Yuto2511/RoboTrace_2023/README.md

# RoboTrace_2023

2023年に製作するロボトレーサーのリポジトリ(見返すためのメモ)  

## Technical data

### CPU 
ARM系 / STmicro stm32f405

### バッテリー
CPU,モータ共用  
Lipo / 3セル / -[v] / -[mAh] / -  

### モータ
- 走行用　DCモータ : 2[個] / maxon DCX10L  
- 走行以外 DCモータ : 1[個] / maxon DCX8M  
- モータドライバIC : DRV8874,DRV8876

### センサ
- 赤外線センサ : 6[個] / TEMT7100X01 / ラインセンサ(反射光AD変換)  
- 赤外線センサ : 2[個] / S7136 / サイドセンサ  
- ジャイロセンサ : 1[個] / ICM20649 / デジタル値出力型  
- エンコーダ : 2[個] / ENX 10 EASY  
- エンコーダ : 1[個] / ENX 8 MAG  

### サイズ
- -x-[mm]
- -[g]

### 動輪
4輪 / 直径24mm 幅　12mm

### 速度
- 直進最高速度 : -[m/s]
- 加速度 : -[m/s^2]
- 加速度 : -[m/s^2]

## 機械設計
### CAD
RoboTrace_2023_aseembly

### モータ
- 駆動輪 : DCX10L
- センサステア : DCX8M
- 吸引 : 8520モータ

### ギヤ
- 駆動輪
  - ピニオン : M0.3, Z28
  - 動輪ギヤ : M0.3, Z63
- センサステア
  - ピニオン : M0.5, Z10
  - [クラウンギヤ](https://www.tamiya.com/japan/products/15462/index.html) : M0.5, Z20
  - [スパーギヤ](https://www.tamiya.com/japan/products/15434/index.html) : M0.5, Z26

### その他
- フレーム : カーボン板(1mm)
- プリントパーツ : Onyx(Mark Two), -(光造形)
- シャフト : アルミ丸棒(4mm), ステンレス丸棒(3mm)
- ベアリング : 内径4mm外形7mm, 内径3mm外形6mm
- ねじ : M2, M2.6

## 回路設計

### 回路図
[回路図](https://github.com/Yuto2511/RoboTrace_2023/blob/main/RoboTrace_2023.pdf)

### パーツ一覧

#### CPU
- [STM32F405RGT6](https://www.stmcu.jp/stm32/stm32f4/stm32f405415/12229/) o
- [クロック-DSC6021CI2](https://www.digikey.jp/ja/products/detail/microchip-technology/DSC6021CI2A-009S/8639204) o

#### 電源
- XT60コネクタ-オス-XT60U-M o
- IL-Gコネクタ-2極-2.5ピッチ-IL-G-2P-S3T2-SA o
- [PchMOSFET-55V-18A](https://akizukidenshi.com/catalog/g/gI-06021/) x
- [DC/DC-LXDC55FAAA-203](https://akizukidenshi.com/catalog/g/gM-09577/) o
- [積層セラミックコンデンサ-4.7uF-50V](https://akizukidenshi.com/catalog/g/gP-15634/) o
- [アルミ電解コンデンサ-100uF-16V](https://akizukidenshi.com/catalog/g/gP-17422/) o
- [積層セラミックコンデンサ-2.2uF-35V](https://akizukidenshi.com/catalog/g/gP-16077/) o
- [積層セラミックコンデンサ-10uF-35V](https://akizukidenshi.com/catalog/g/gP-13336/) x
- [レギュレタ-NJU7223DL1](https://akizukidenshi.com/catalog/g/gI-03705/) x
- [ショットキーバリアダイオード-MA10EB045](https://www.digikey.jp/ja/products/detail/kyocera-avx/MA10EB045/16580541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) o
- [スライドスイッチ-1回路2接点](https://akizukidenshi.com/catalog/g/gP-13989/) x
- [緑色チップLED-OSTG1608C1A](https://akizukidenshi.com/catalog/g/gI-06417/) o

#### モータ
- [モータドライバ-DRV8874](https://www.mouser.jp/ProductDetail/Texas-Instruments/DRV8874QPWPRQ1?qs=mAH9sUMRCttZUT1myh3Itg%3D%3D) o
- [モータドライバ-DRV8876](https://www.digikey.jp/ja/products/detail/texas-instruments/DRV8876PWPR/10270191) o
- [積層セラミックコンデンサ-22pF-50V](https://akizukidenshi.com/catalog/g/gP-11626/) o
- [アルミ電解コンデンサ-100uF-16V](https://akizukidenshi.com/catalog/g/gP-17422/) o
- PAコネクタ-2極 o
- [FFCコネクタ-12極-0.5ピッチ](https://www.digikey.jp/ja/products/detail/molex/0527451297/3044841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) o
- FTSHコネクタ-10極-1.27ピッチ-FTSH-105-01-L-D-K o
- [NchMOSFET-30V-5.7A](https://akizukidenshi.com/catalog/g/gI-14653/) x
- [ショットキーバリアダイオード-40V-2A](https://akizukidenshi.com/catalog/g/gI-02073/) x
- [積層セラミックコンデンサ-10uF-35V](https://akizukidenshi.com/catalog/g/gP-13336/) x

#### センサ
- [IMU-ICM20649](https://www.digikey.jp/ja/products/detail/tdk-invensense/ICM-20649/8540792) o
- [フォトトランジスタ-TEMT7100X01](https://www.digikey.jp/ja/products/detail/vishay-semiconductor-opto-division/TEMT7100X01/4743803) o
- [赤外線LED-SIR19-21/TR8](https://www.digikey.jp/ja/products/detail/everlight-electronics-co-ltd/SIR19-21C-TR8/2676159) o
- [光変調型フォトIC-S7136](https://akizukidenshi.com/catalog/g/gI-02425/) o
- [FFCケーブル-8極-0.5ピッチ](https://www.digikey.jp/ja/products/detail/molex/0151660081/3280963) x  
- [FFCコネクタ-8極-0.5ピッチ](https://www.digikey.jp/ja/products/detail/molex/5051100892/5700456) x  

#### その他・共通
- [白色チップLED-OSWT1608](https://akizukidenshi.com/catalog/g/gI-03986/) o
- [表面実装タクトスイッチ-TVAF06-A020B-R](https://akizukidenshi.com/catalog/g/gP-14888/) o
- SHコネクタ-3~6極-1.0ピッチ o

## プログラム
