Yuto2511/RoboTrace_2023/Core/Src/main.c

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
/* Includes ------------------------------------------------------------------*/
#include "main.h"

/* USER CODE BEGIN Includes */
#include "wrapper.h"
#include <stdio.h>
/* USER CODE END Includes */

ADC_HandleTypeDef hadc1;
DMA_HandleTypeDef hdma_adc1;

I2C_HandleTypeDef hi2c1;

RTC_HandleTypeDef hrtc;

SPI_HandleTypeDef hspi1;

TIM_HandleTypeDef htim1;
TIM_HandleTypeDef htim2;
TIM_HandleTypeDef htim3;
TIM_HandleTypeDef htim4;
TIM_HandleTypeDef htim5;
TIM_HandleTypeDef htim6;
TIM_HandleTypeDef htim7;
TIM_HandleTypeDef htim8;
TIM_HandleTypeDef htim9;
TIM_HandleTypeDef htim10;
TIM_HandleTypeDef htim11;
TIM_HandleTypeDef htim12;

UART_HandleTypeDef huart1;

void SystemClock_Config(void);
static void MX_GPIO_Init(void);
static void MX_DMA_Init(void);
static void MX_ADC1_Init(void);
static void MX_I2C1_Init(void);
static void MX_RTC_Init(void);
static void MX_SPI1_Init(void);
static void MX_TIM1_Init(void);
static void MX_TIM2_Init(void);
static void MX_TIM3_Init(void);
static void MX_TIM4_Init(void);
static void MX_TIM5_Init(void);
static void MX_TIM8_Init(void);
static void MX_TIM9_Init(void);
static void MX_TIM10_Init(void);
static void MX_TIM11_Init(void);
static void MX_TIM12_Init(void);
static void MX_USART1_UART_Init(void);
static void MX_TIM6_Init(void);
static void MX_TIM7_Init(void);
/* USER CODE BEGIN PFP */
int _write(int, char*, int);
/* USER CODE END PFP */

/* USER CODE BEGIN 0 */

const uint32_t start_address_sector10 = 0x80C0000;	//sector10 start address
const uint32_t end_address_sector10 = 0x80DFFFF;		//sector10 end address
const uint32_t start_address_sector11 = 0x80E0000;	//sector11 start address
const uint32_t end_address_sector11 = 0x80FFFFF;		//sector11 end address

WRITE_DATA_SECTOR11 write_data_sector11 = {{0}};
READ_DATA_SECTOR11 read_data_sector11 = {{0}};
WRITE_DATA_SECTOR10 write_data_sector10 = {{0}};
READ_DATA_SECTOR10 read_data_sector10 = {{0}};

int _write(int file, char *ptr, int len) {
	HAL_UART_Transmit(&huart1, (uint8_t*)ptr, len, 0xFFFF);
	return len;
}

/* USER CODE END 0 */

/**
  * @brief  The application entry point.
  * @retval int
  */
int main(void)
{
  /* MCU Configuration--------------------------------------------------------*/

  /* Reset of all peripherals, Initializes the Flash interface and the Systick. */
  HAL_Init();

  /* Configure the system clock */
  SystemClock_Config();

  /* Initialize all configured peripherals */
  MX_GPIO_Init();
  MX_DMA_Init();
  MX_ADC1_Init();
  MX_I2C1_Init();
  MX_RTC_Init();
  MX_SPI1_Init();
  MX_TIM1_Init();
  MX_TIM2_Init();
  MX_TIM3_Init();
  MX_TIM4_Init();
  MX_TIM5_Init();
  MX_TIM8_Init();
  MX_TIM9_Init();
  MX_TIM10_Init();
  MX_TIM11_Init();
  MX_TIM12_Init();
  MX_USART1_UART_Init();
  MX_TIM6_Init();
  MX_TIM7_Init();
  /* USER CODE BEGIN 2 */
  HAL_TIM_Base_Start_IT(&htim6);
  HAL_TIM_Base_Start_IT(&htim7);
  init();
  // reload flash data
  loadFlash(start_address_sector11, (uint8_t*)&read_data_sector11, sizeof(READ_DATA_SECTOR11));
  loadFlash(start_address_sector10, (uint8_t*)&read_data_sector10, sizeof(READ_DATA_SECTOR10));

  /* USER CODE END 2 */

  /* Infinite loop */
  /* USER CODE BEGIN WHILE */
  while (1)
  {
	  main_loop();
    /* USER CODE END WHILE */

    /* USER CODE BEGIN 3 */
  }
  /* USER CODE END 3 */
}

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
/* USER CODE BEGIN 4 */
void HAL_TIM_PeriodElapsedCallback(TIM_HandleTypeDef *htim)
{
	// TIM6
	if (htim->Instance == TIM6)
	{
		PeriodElapsed_005ms();
	}
	// TIM7
	if (htim->Instance == TIM7)
	{
		PeriodElapsed_05ms();
	}
}
/* USER CODE END 4 */
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
