Yuto2511/RoboTrace_2023/Core/Inc/accelerometer.h

/*
 * accelerometer.h
 *
 *  Created on: Jan 17, 2024
 *      Author: youto
 */

#ifndef INC_ACCELEROMETER_H_
#define INC_ACCELEROMETER_H_

#include "ICM_20649.h"

double pre_zg;

double z_gyro();

#endif /* INC_ACCELEROMETER_H_ */
