Yuto2511/RoboTrace_2023/Core/Inc/analog.h

/*
 * analog.h
 *
 *  Created on: Jan 17, 2024
 *      Author: youto
 */

#ifndef INC_ANALOG_H_
#define INC_ANALOG_H_

#include <stdio.h>
#include "stm32f4xx_hal.h"
#include "macro.h"

extern ADC_HandleTypeDef hadc1;
extern DMA_HandleTypeDef hdma_adc1;

void ADCStart();
void adc_getValues();
void updateValues();
void Sens_Calibration();

uint32_t num;
uint16_t line_R1_[10], line_R2_[10], line_R3_[10], line_L1_[10], line_L2_[10], line_L3_[10];
uint16_t analog_[ADC_SENS];
int R_Min, R_Max, L_Min, L_Max;
float Line_Sens_R, Line_Sens_L, Stear_Sens, Line_Calib_R, Line_Calib_L;

#endif /* INC_ANALOG_H_ */
