Yuto2511/RoboTrace_2023/Core/Inc/led.h

/*
 * led.h
 *
 *  Created on: Jan 17, 2024
 *      Author: youto
 */

#ifndef INC_LED_H_
#define INC_LED_H_

#include "stm32f4xx_hal.h"

void led_num(uint8_t num);
void led_flg(uint8_t flg);

#endif /* INC_LED_H_ */
