Yuto2511/RoboTrace_2023/Core/Src/led.c

/*
 * led.c
 *
 *  Created on: Jan 17, 2024
 *      Author: youto
 */


#include "led.h"

void led_num(uint8_t num)
{
	// 1000
	if(num >= 8){
		num = num - 8;
		HAL_GPIO_WritePin(GPIOD, GPIO_PIN_2, GPIO_PIN_RESET);
	}
	else HAL_GPIO_WritePin(GPIOD, GPIO_PIN_2, GPIO_PIN_SET);
	// 0001
	if( !(num % 2) ) HAL_GPIO_WritePin(GPIOC, GPIO_PIN_0, GPIO_PIN_RESET);
	else HAL_GPIO_WritePin(GPIOC, GPIO_PIN_0, GPIO_PIN_SET);

	// 0010
	if( (num/2)%2 ) HAL_GPIO_WritePin(GPIOC, GPIO_PIN_14, GPIO_PIN_RESET);
	else HAL_GPIO_WritePin(GPIOC, GPIO_PIN_14, GPIO_PIN_SET);

	// 0100
	if( num >= 4 ) HAL_GPIO_WritePin(GPIOC, GPIO_PIN_12, GPIO_PIN_RESET);
	else HAL_GPIO_WritePin(GPIOC, GPIO_PIN_12, GPIO_PIN_SET);
}

void led_flg(uint8_t flg)
{
	if(flg) HAL_GPIO_WritePin(GPIOD, GPIO_PIN_2, GPIO_PIN_RESET);
	else HAL_GPIO_WritePin(GPIOD, GPIO_PIN_2, GPIO_PIN_SET);
}
