Yuto2511/RoboTrace_2023/RoboTrcae_2023_TestProject.ioc

Mcu.UserName=STM32F405RGTx
PA0-WKUP.Signal=S_TIM5_CH1
PA1.Signal=S_TIM2_CH2
PA10.Signal=USART1_RX
PA12.Signal=GPIO_Output
PA13.Signal=SYS_JTMS-SWDIO
PA14.Signal=SYS_JTCK-SWCLK
PA15.Signal=S_TIM2_CH1_ETR
PA2.Signal=S_TIM9_CH1
PA3.Signal=ADCx_IN3
PA4.Signal=ADCx_IN4
PA5.Signal=SPI1_SCK
PA6.Signal=SPI1_MISO
PA7.Signal=SPI1_MOSI
PA8.Signal=S_TIM1_CH1
PA9.Signal=USART1_TX
PB0.Signal=ADCx_IN8
PB1.Signal=ADCx_IN9
PB10.Signal=GPIO_Input
PB11.Signal=GPIO_Input
PB14.Signal=S_TIM12_CH1
PB15.Signal=GPIO_Output
PB2.Signal=GPIO_Input
PB3.Signal=SYS_JTDO-SWO
PB4.Signal=S_TIM3_CH1
PB5.Signal=S_TIM3_CH2
PB6.Signal=S_TIM4_CH1
PB7.Signal=S_TIM4_CH2
PB8.Signal=I2C1_SCL
PB9.Signal=I2C1_SDA
PC0.Signal=GPIO_Input
PC1.Signal=ADCx_IN11
PC10.Signal=GPIO_Input
PC11.Signal=GPIO_Input
PC12.Signal=GPIO_Input
PC13-ANTI_TAMP.Signal=GPIO_Output
PC14-OSC32_IN.Signal=GPIO_Input
PC2.Signal=ADCx_IN12
PC3.Signal=GPIO_Output
PC4.Signal=GPIO_Output
PC5.Signal=ADCx_IN15
PC6.Signal=S_TIM8_CH1
PC9.Signal=GPIO_Output
PD2.Signal=GPIO_Input
PH0-OSC_IN.Signal=RCC_OSC_IN
PH1-OSC_OUT.Signal=RCC_OSC_OUT
