Yuto2511/RoboTrace_2023/(commit log)

2024-01-25 二次走行のコードを追加
2024-01-25 修正とデバックモード追加
